MINGKK2/ADCS-satellite-using-stm32F405RGT6/docs/diagrams/diagram-saved.png

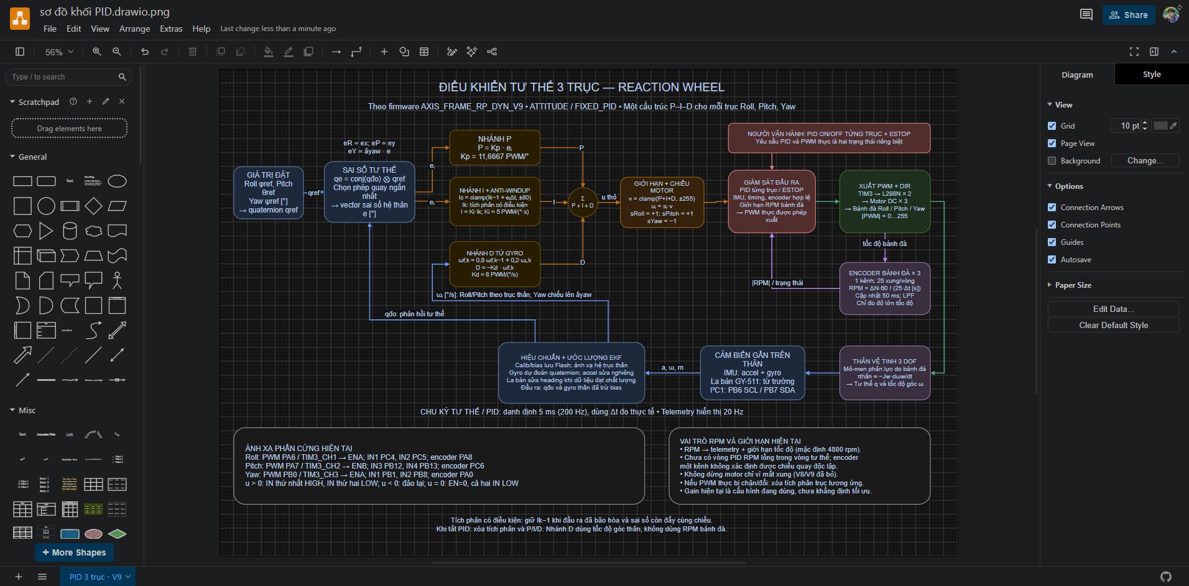
docs/diagrams/diagram-saved.png
