MINGKK2/ADCS-satellite-using-stm32F405RGT6/viewer/report-fixtures/synthetic-yaw-step.csv

elapsed_s | pc_elapsed_s | pc_received_utc | board_uptime_ms | sequence | valid | imu_age_ms | gap_before | invalid_reason | estop | firmware | mag_state | mag_state_age_ms | diagnostic_age_ms | kp | ki | kd | angle_roll_deg | angle_pitch_deg | angle_yaw_deg | target_roll_deg | target_pitch_deg | target_yaw_deg | error_roll_deg | error_pitch_deg | error_yaw_deg | bodyError_roll_deg | bodyError_pitch_deg | bodyError_yaw_deg | gyro_roll_deg_s | gyro_pitch_deg_s | gyro_yaw_deg_s | pwm_roll_count | pwm_pitch_count | pwm_yaw_count | requested_roll_count | requested_pitch_count | requested_yaw_count | pidOutput_roll_count | pidOutput_pitch_count | pidOutput_yaw_count | rpm_roll_rpm | rpm_pitch_rpm | rpm_yaw_rpm | pid_roll_enabled | pid_pitch_enabled | pid_yaw_enabled | active_roll_enabled | active_pitch_enabled | active_yaw_enabled | blocked_roll_mask | blocked_pitch_mask | blocked_yaw_mask | installed_roll_present | installed_pitch_present | installed_yaw_present
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
