MINGKK2/ADCS-satellite-using-stm32F405RGT6/firmware/STM32CubeIDE.ioc

Mcu.UserName=STM32F405RGTx
PA11.Signal=USB_OTG_FS_DM
PA12.Signal=USB_OTG_FS_DP
PA13.Signal=SYS_JTMS-SWDIO
PA14.Signal=SYS_JTCK-SWCLK
PB6.Signal=I2C1_SCL
PB7.Signal=I2C1_SDA
PC14-OSC32_IN.Signal=RCC_OSC32_IN
PC15-OSC32_OUT.Signal=RCC_OSC32_OUT
PH0-OSC_IN.Signal=RCC_OSC_IN
PH1-OSC_OUT.Signal=RCC_OSC_OUT
PA9.Signal=USART1_TX
PA10.Signal=USART1_RX
