MINGKK2/ADCS-satellite-using-stm32F405RGT6/firmware/Core/Inc/telemetry_protocol.h

#ifndef TELEMETRY_PROTOCOL_H
#define TELEMETRY_PROTOCOL_H
#include "telemetry_data.h"
#include <stddef.h>
#include <stdint.h>
void TelemetryProtocol_Init(void);
void TelemetryProtocol_Service(const TelemetryData *data);
uint8_t TelemetryProtocol_Event(const uint8_t *data,size_t length);
#endif
