MINGKK2/ADCS-satellite-using-stm32F405RGT6/firmware/Core/Src/dma.c

/* USART1 DMA2 clock/NVIC. Settings are mirrored in STM32CubeIDE.ioc. */
#include "dma.h"
void MX_DMA_Init(void) {
  __HAL_RCC_DMA2_CLK_ENABLE();
  HAL_NVIC_SetPriority(DMA2_Stream2_IRQn,6,0);
  HAL_NVIC_EnableIRQ(DMA2_Stream2_IRQn);
  HAL_NVIC_SetPriority(DMA2_Stream7_IRQn,6,0);
  HAL_NVIC_EnableIRQ(DMA2_Stream7_IRQn);
}
