MINGKK2/ADCS-satellite-using-stm32F405RGT6/tests/test-adcs-cases.c

static void test_geometry(void){
  float q[4]={1,0,0,0},t[3]={0,0,90},e[3];
  assert(ADCS_AttitudeError(q,t,e));assert(fabsf(e[2]-90)<.001f);
  q[0]=-1;assert(ADCS_AttitudeError(q,t,e));assert(fabsf(e[2]-90)<.001f);
  float h=179*DEG_TO_RAD*.5f;q[0]=cosf(h);q[3]=sinf(h);t[2]=-179;
  assert(ADCS_AttitudeError(q,t,e));assert(fabsf(e[2]-2)<.001f);
  /* At roll=90, a world Z heading change is a body +Y rotation. */
  q[0]=q[1]=sqrtf(.5f);q[2]=q[3]=0;t[0]=90;t[1]=0;t[2]=10;
  assert(ADCS_AttitudeError(q,t,e));assert(fabsf(e[0])<.001f&&fabsf(e[1]-10)<.001f&&fabsf(e[2])<.001f);
  q[0]=NAN;assert(!ADCS_AttitudeError(q,t,e));
  fusion_status=HAL_OK;pid_enabled[2]=1;QuaternionNormalize(q);
  assert(fusion_status==HAL_ERROR && pid_enabled[2] && isfinite(q[0]));
  puts("PASS quaternion shortest path, q/-q, mixed axes, invalid quaternion");
}
static void test_pid(void){
  AxisControl_t c={0};
  for(int i=0;i<10000;i++)assert(AxisControl_Update(&c,0,90,0,28,1.2f,4,80,-1,.005f,1)==-255);
  assert(c.integral==0);assert(c.saturated);
  AxisControl_Update(&c,0,0,0,28,1.2f,4,80,-1,.005f,0);
  assert(c.output_pwm==0 && c.i_term==0);
  int command=AxisControl_Update(&c,0,1,0,28,1.2f,4,80,1,.005f,1);
  assert(command==28 && c.error_deg==1);
  puts("PASS actual PID output clamp, saturation anti-windup, disabled reset");
}
static void test_encoder(void){
  memset(wheel_encoder,0,sizeof(wheel_encoder));TIM_TypeDef timer={0};
  WheelEncoder_t *enc=&wheel_encoder[2];motor_command[2]=100;
  WheelEncoder_UpdateOne(enc,&timer,1);assert(!enc->fault_flags);
  WheelEncoder_UpdateOne(enc,&timer,1501);assert(!enc->fault_flags);
  timer.CNT=25;WheelEncoder_UpdateOne(enc,&timer,1551);
  assert(!enc->fault_flags && enc->pulse_seen && enc->last_edge_tick_ms==1551);
  assert(fabsf(enc->raw_rpm-1200)<.001f);
  Motor_ApplySupervisedCommand(2,120);assert(motor_command[2]==120);
  enc->fault_flags=2;Motor_ApplySupervisedCommand(2,120);assert(motor_command[2]==0);
  /* Implausible-rate faults and raw overspeed remain separate from missing pulses. */
  enc->fault_flags=0;enc->rpm=100;enc->raw_rpm=4900;enc->speed_valid=1;
  Motor_ApplySupervisedCommand(2,120);assert(motor_command[2]==0&&enc->overspeed_limited);
  enc->raw_rpm=4700;Motor_ApplySupervisedCommand(2,120);assert(motor_command[2]==0);
  enc->raw_rpm=4500;Motor_ApplySupervisedCommand(2,120);assert(motor_command[2]==120);
  timer.CNT+=100000;WheelEncoder_UpdateOne(enc,&timer,1601);
  assert((enc->fault_flags&2)&&!enc->speed_valid);
  memset(enc,0,sizeof(*enc));enc->counter_is_16_bit=1;enc->previous_count=65530;
  enc->count=INT32_MAX-2;timer.CNT=4;WheelEncoder_UpdateOne(enc,&timer,50);
  assert(enc->last_delta_count==10 && enc->count==INT32_MAX);
  assert(fabsf(enc->raw_rpm-480)<.001f);
  puts("PASS actual encoder PPR, timer wrap, fault latch, raw overspeed/hysteresis, noise, total saturation");
}
static void test_encoder_no_pulse_stop_disabled(void){
  memset(wheel_encoder,0,sizeof(wheel_encoder));memset(pid_enabled,1,sizeof(pid_enabled));
  for(unsigned axis=0;axis<3;axis++){
    TIM_TypeDef timer={0};WheelEncoder_t *enc=&wheel_encoder[axis];enc->counter_is_16_bit=axis!=2;
    for(unsigned sample=1;sample<=1200;sample++){
      WheelEncoder_UpdateOne(enc,&timer,sample*50U);
      int command=sample<=600?255:-255;
      assert(enc->speed_valid && !enc->fault_flags && enc->rpm==0 && enc->count==0);
      assert(Motor_ApplySupervisedCommand((MotorAxis_t)axis,command)==command);
      assert(pid_enabled[axis]);
    }
  }
  memset(motor_command,0,sizeof(motor_command));memset(pid_enabled,0,sizeof(pid_enabled));
  puts("PASS actual all3axes:60seconds without pulses at PWM+/-255 does not fault, block PWM or change PID request");
}
static void test_encoder_recovery(void){
  memset(wheel_encoder,0,sizeof(wheel_encoder));memset(pid_enabled,0,sizeof(pid_enabled));
  memset(motor_command,0,sizeof(motor_command));TIM_TypeDef timer={0};
  WheelEncoder_t *enc=&wheel_encoder[0];enc->fault_flags=2;enc->speed_valid=1;enc->pulse_seen=1;
  assert(!WheelEncoder_CanClear(0)); /* Pulse evidence from before fault is insufficient. */
  timer.CNT=24;WheelEncoder_UpdateOne(enc,&timer,100);assert(!WheelEncoder_CanClear(0));
  timer.CNT=25;WheelEncoder_UpdateOne(enc,&timer,150);assert(WheelEncoder_CanClear(0));
  WheelEncoder_UpdateOne(enc,&timer,50000);assert(WheelEncoder_CanClear(0)&&enc->fault_flags==2);
  pid_enabled[0]=1;assert(!WheelEncoder_CanClear(0));pid_enabled[0]=0;
  motor_command[0]=80;assert(!WheelEncoder_CanClear(0));motor_command[0]=0;
  timer.CNT+=100000;WheelEncoder_UpdateOne(enc,&timer,50001);
  assert(!WheelEncoder_CanClear(0)&&enc->recovery_pulses==0);
  WheelEncoder_UpdateOne(enc,&timer,50051);assert(!WheelEncoder_CanClear(0));
  /* Unsigned tick wrap with zero pulses remains valid zero RPM and never trips. */
  memset(enc,0,sizeof(*enc));timer.CNT=0;motor_command[0]=100;
  enc->previous_tick_ms=UINT32_MAX-100;
  WheelEncoder_UpdateOne(enc,&timer,1398);assert(!enc->fault_flags);
  WheelEncoder_UpdateOne(enc,&timer,1399);assert(!enc->fault_flags&&enc->speed_valid);
  assert(Motor_ApplySupervisedCommand(0,100)==100);
  memset(motor_command,0,sizeof(motor_command));
  puts("PASS actual encoder explicit recovery:25 disarmed pulses, no auto-clear, no armed clear, tick wrap");
}
static void test_accel_covariance(void){
  float bias[3]={0},accel[3]={0,0,16384};AttitudeEKF_Init(bias,accel);
  attitude_ekf.covariance[0][3]=attitude_ekf.covariance[3][0]=.0001f;
  float before=attitude_ekf.covariance[3][3];
  for(int i=0;i<5000;i++)AttitudeEKF_AccelerometerUpdate(0,0,16384);
  assert(fabsf(attitude_ekf.covariance[3][3]-before)<1e-9f);
  for(unsigned i=0;i<6;i++)for(unsigned j=0;j<6;j++){
    assert(isfinite(attitude_ekf.covariance[i][j]));
    assert(fabsf(attitude_ekf.covariance[i][j]-attitude_ekf.covariance[j][i])<1e-7f);
  }
  puts("PASS actual accel update: no false bias covariance reduction, finite symmetric covariance");
}
static void test_fusion(void){
  float bias[3]={0},accel[3]={0,0,16384};AttitudeEKF_Init(bias,accel);
  memset(motor_command,0,sizeof(motor_command));memset(wheel_encoder,0,sizeof(wheel_encoder));
  memset(&magnetometer,0,sizeof(magnetometer));magnetometer.reference_valid=1;
  magnetometer.reference_world[0]=.8f;magnetometer.reference_world[2]=.6f;magnetometer.reference_norm=1;
  float truth=0;
  int16_t ax=(int16_t)lroundf(accel_offset_raw[0]),ay=(int16_t)lroundf(accel_offset_raw[1]);
  int16_t az=(int16_t)lroundf(accel_offset_raw[2]-16384/accel_scale[2]);
  for(int n=0;n<24000;n++){
    float rate=(n>=8000 && n<8400)?45:0;truth+=rate*.005f;
    int16_t gz=(int16_t)lroundf(-(rate+.573f)*GYRO_LSB_PER_DPS);
    tick=(uint32_t)(n+1)*5;
    AttitudeEKF_Update(ax,ay,az,0,0,gz,.005f);
    if(n%4==0){float mag[3]={.8f*cosf(truth*DEG_TO_RAD),-.8f*sinf(truth*DEG_TO_RAD),.6f};AttitudeEKF_MagnetometerUpdate(mag);}
  }
  float roll,pitch,yaw;QuaternionToEuler(attitude_ekf.q,&roll,&pitch,&yaw);
  printf("Actual ESKF synthetic 120s: truth=%.2f yaw=%.4f, biasZ=%.4f deg/s; accepted=%lu rejected=%lu\n",truth,yaw,attitude_ekf.gyro_bias_rad_s[2]*RAD_TO_DEG,(unsigned long)attitude_ekf.mag_accepted,(unsigned long)attitude_ekf.mag_rejected);
  assert(fabsf(yaw-truth)<.1f && fabsf(roll)<.1f && fabsf(pitch)<.1f);
  /* Failed incomplete mag capture retains previous coefficients. */
  magnetometer.offset[0]=123;magnetometer.offset[1]=-234;magnetometer.offset[2]=345;
  assert(GY511_MagCalibrate()==HAL_ERROR);
  assert(magnetometer.offset[0]==123 && magnetometer.offset[1]==-234 && magnetometer.offset[2]==345);
  puts("PASS actual gyro propagation+accel+mag retains rotated 90deg pose; failed mag capture preserves calibration");
}
static void test_compass_dropout(void){
  float bias[3]={0},accel[3]={0,0,16384};AttitudeEKF_Init(bias,accel);
  attitude_ekf.q[0]=cosf(22.5f*DEG_TO_RAD);attitude_ekf.q[3]=sinf(22.5f*DEG_TO_RAD);
  AttitudeEKF_RefreshEuler();
  memset(&magnetometer,0,sizeof(magnetometer));magnetometer.reference_valid=1;
  magnetometer.reference_norm=1000;magnetometer.reference_world[0]=.8f;magnetometer.reference_world[2]=.6f;
  for(unsigned i=0;i<3;i++)magnetometer.scale[i]=1;
  fusion_status=HAL_OK;mag_status=HAL_OK;pid_enabled[2]=1;
  float initial_q[4];memcpy(initial_q,attitude_ekf.q,sizeof(initial_q));
  for(unsigned i=0;i<20;i++){tick+=20;Magnetometer_ProcessSample(HAL_ERROR,0,0,0);}
  assert(mag_status==HAL_ERROR && fusion_status==HAL_OK && pid_enabled[2]);
  assert(!memcmp(initial_q,attitude_ekf.q,sizeof(initial_q)));
  int16_t ax=(int16_t)lroundf(accel_offset_raw[0]),ay=(int16_t)lroundf(accel_offset_raw[1]);
  int16_t az=(int16_t)lroundf(accel_offset_raw[2]-16384/accel_scale[2]);
  AxisControl_t control={0};control.setpoint_deg=45;
  for(unsigned i=0;i<1200;i++){
    tick+=5;AttitudeEKF_Update(ax,ay,az,0,0,0,.005f);
    if(i%4==0)Magnetometer_ProcessSample(HAL_ERROR,0,0,0);
    float target[3]={0,0,45},error[3];assert(ADCS_AttitudeError(attitude_ekf.q,target,error));
    (void)AxisControl_Update(&control,attitude_ekf.yaw_deg,error[2],0,28,1.2f,4,80,-1,.005f,pid_enabled[2]);
  }
  assert(pid_enabled[2] && fusion_status==HAL_OK && fabsf(attitude_ekf.yaw_deg-45)<.1f);
  Magnetometer_ProcessSample(HAL_OK,10000,0,0);
  assert(mag_reject_reason==1 && pid_enabled[2] && fusion_status==HAL_OK);
  Magnetometer_ProcessSample(HAL_OK,-566,-566,600);
  assert(mag_reject_reason==3 && fabsf(mag_innovation_deg)>100 && pid_enabled[2]);
  Magnetometer_ProcessSample(HAL_OK,566,566,600);
  assert(mag_status==HAL_OK && mag_reject_reason==0 && pid_enabled[2] && fusion_status==HAL_OK);
  assert(fabsf(attitude_ekf.yaw_deg-45)<.1f && control.setpoint_deg==45);
  puts("PASS actual 6s compass I2C dropout, rejected norm/heading and recovery: PID stays enabled, IMU runs, angle/target retained");
}
static void test_operator_authority(void){
  control_targets_initialized=1;pid_enabled[0]=1;pid_enabled[1]=0;pid_enabled[2]=1;
  roll_control.setpoint_deg=10;pitch_control.setpoint_deg=20;yaw_control.setpoint_deg=90;
  attitude_ekf.yaw_deg=45;attitude_ekf.roll_deg=0;attitude_ekf.pitch_deg=0;
  AttitudeControl_Reset();
  assert(pid_enabled[0]&&!pid_enabled[1]&&pid_enabled[2]);
  assert(roll_control.setpoint_deg==10&&pitch_control.setpoint_deg==20&&yaw_control.setpoint_deg==90);
  float bias[3]={0},accel[3]={0,0,16384};AttitudeEKF_Init(bias,accel);
  assert(fabsf(attitude_ekf.yaw_deg-45)<.001f);
  AttitudeControl_Reset();assert(pid_enabled[2]&&yaw_control.setpoint_deg==90);
  float measured_before[4];memcpy(measured_before,attitude_ekf.q,sizeof(measured_before));
  AttitudeControl_HoldCurrentYaw();
  assert(fabsf(yaw_control.setpoint_deg-45)<.001f && pid_enabled[2]);
  assert(!memcmp(measured_before,attitude_ekf.q,sizeof(measured_before)));
  puts("PASS operator PID latch/targets survive controller and EKF recovery; retained yaw is measured 45deg, not target 90deg");
  control_timing_paused=0;
  assert(ControlTiming_Accept(5,0)&&!control_timing_paused);
  assert(ControlTiming_Accept(25,100)&&control_timing_paused);
  assert(ControlTiming_Accept(5,199)&&control_timing_paused);
  assert(ControlTiming_Accept(5,200)&&!control_timing_paused);
  assert(!ControlTiming_Accept(101,250)&&control_timing_paused&&pid_enabled[2]);
  control_timing_paused=0;
  assert(ControlTiming_Accept(25,0xFFFFFFF0U)&&control_timing_paused);
  assert(ControlTiming_Accept(5,83)&&control_timing_paused);
  assert(ControlTiming_Accept(5,84)&&!control_timing_paused&&pid_enabled[2]);
  puts("PASS timing pause/recovery and tick wrap: 25ms does not reinitialize EKF, >100ms requests recovery but never clears operator PID");
}
static void test_autonomous_hold(void){
  control_targets_initialized=1;control_timing_paused=0;
  pid_enabled[0]=pid_enabled[1]=0;pid_enabled[2]=1;
  roll_control.setpoint_deg=pitch_control.setpoint_deg=0;yaw_control.setpoint_deg=90;
  attitude_ekf.q[0]=cosf(22.5f*DEG_TO_RAD);attitude_ekf.q[1]=attitude_ekf.q[2]=0;
  attitude_ekf.q[3]=sinf(22.5f*DEG_TO_RAD);AttitudeEKF_RefreshEuler();
  AttitudeControl_Reset();
  for(unsigned i=0;i<120000;i++){
    tick+=5;assert(ControlTiming_Accept(5,tick));
    if(i==60000)AttitudeControl_Reset();
    float target[3]={0,0,yaw_control.setpoint_deg},error[3];
    assert(ADCS_AttitudeError(attitude_ekf.q,target,error));
    int32_t pwm=AxisControl_Update(&yaw_control,attitude_ekf.yaw_deg,error[2],0,28,2.4f,8,80,-1,.005f,pid_enabled[2]);
    assert(pid_enabled[2]&&yaw_control.setpoint_deg==90);
    assert(fabsf(attitude_ekf.yaw_deg-45)<.001f&&pwm>=-255&&pwm<=255&&pwm!=0);
  }
  puts("PASS autonomous hold: 600 simulated seconds without commands; target/PID survive controller recovery; measured 45deg remains separate from target 90deg");
}
static void test_measured_body_frame(void){
  float old[3]={.01f,.02f,.03f},body[3],restored[3];
  ADCS_LegacyToBody(old,body);ADCS_BodyToLegacy(body,restored);
  assert(body[0]==old[1]&&body[1]==-old[0]&&body[2]==old[2]);
  assert(!memcmp(old,restored,sizeof(old)));
  float ex[3]={1,0,0},ey[3]={0,1,0},ez[3]={0,0,1};
  ADCS_LegacyToBody(ex,ex);ADCS_LegacyToBody(ey,ey);ADCS_LegacyToBody(ez,ez);
  float cross[3]={ex[1]*ey[2]-ex[2]*ey[1],ex[2]*ey[0]-ex[0]*ey[2],ex[0]*ey[1]-ex[1]*ey[0]};
  for(unsigned i=0;i<3;i++)assert(cross[i]==ez[i]);
  float gy[3];SensorToBodyGyroRad(0,GYRO_LSB_PER_DPS,0,gy);
  assert(fabsf(gy[0]-DEG_TO_RAD)<1e-7f&&gy[1]==0&&gy[2]==0);
  SensorToBodyGyroRad(GYRO_LSB_PER_DPS,0,0,gy);
  assert(gy[0]==0&&fabsf(gy[1]-DEG_TO_RAD)<1e-7f&&gy[2]==0);
  SensorToBodyGyroRad(0,0,GYRO_LSB_PER_DPS,gy);
  assert(gy[0]==0&&gy[1]==0&&fabsf(gy[2]+DEG_TO_RAD)<1e-7f);
  /* Reproduce the held physical Roll pose: legacy pitch +30 degrees. */
  float accel[3],zero[3]={0};control_targets_initialized=0;
  SensorToBodyAccel(accel_offset_raw[0]+.5f*ACCEL_LSB_PER_G/accel_scale[0],
      accel_offset_raw[1],accel_offset_raw[2]-.8660254f*ACCEL_LSB_PER_G/accel_scale[2],accel);
  AttitudeEKF_Init(zero,accel);
  assert(fabsf(attitude_ekf.roll_deg-30)<.001f&&fabsf(attitude_ekf.pitch_deg)<.001f);
  float target[3]={0},error[3];assert(ADCS_AttitudeError(attitude_ekf.q,target,error));
  assert(fabsf(error[0]+30)<.001f&&fabsf(error[1])<.001f);
  /* Legacy roll +30 is new pitch -30 when preserving the existing +Yaw. */
  SensorToBodyAccel(accel_offset_raw[0],accel_offset_raw[1]+.5f*ACCEL_LSB_PER_G/accel_scale[1],
      accel_offset_raw[2]-.8660254f*ACCEL_LSB_PER_G/accel_scale[2],accel);
  AttitudeEKF_Init(zero,accel);
  assert(fabsf(attitude_ekf.roll_deg)<.001f&&fabsf(attitude_ekf.pitch_deg+30)<.001f);
  assert(ADCS_AttitudeError(attitude_ekf.q,target,error));
  assert(fabsf(error[1]-30)<.001f&&fabsf(error[0])<.001f);
  memset(&magnetometer,0,sizeof(magnetometer));for(unsigned i=0;i<3;i++)magnetometer.scale[i]=1;
  GY511_MagToBody(100,200,300,body);assert(body[0]==200&&body[1]==-100&&body[2]==300);
  float legacy_axis[3]={YAW_LEGACY_AXIS_X,YAW_LEGACY_AXIS_Y,YAW_LEGACY_AXIS_Z};
  ADCS_LegacyToBody(legacy_axis,body);
  assert(body[0]==YAW_AXIS_X&&body[1]==YAW_AXIS_Y&&body[2]==YAW_AXIS_Z);
  puts("PASS measured Roll/Pitch mounting, right-handed rotation, gyro/mag consistency, yaw-axis preservation and PID error on the correct body axis");
}
static int16_t test_sensor_word(float value){return (int16_t)lroundf(fmaxf(-32768,fminf(32767,value)));}
static void test_body_sample(float axg,float ayg,float azg,float yaw_rate){
  /* Inverse of the verified current body basis: body=(sensorY,sensorX,-sensorZ). */
  int16_t ax=test_sensor_word(accel_offset_raw[0]+ayg*ACCEL_LSB_PER_G/accel_scale[0]);
  int16_t ay=test_sensor_word(accel_offset_raw[1]+axg*ACCEL_LSB_PER_G/accel_scale[1]);
  int16_t az=test_sensor_word(accel_offset_raw[2]-azg*ACCEL_LSB_PER_G/accel_scale[2]);
  tick+=5;AttitudeEKF_Update(ax,ay,az,0,0,test_sensor_word(-yaw_rate*GYRO_LSB_PER_DPS),.005f);
}
static void test_dynamic_attitude(void){
  float bias[3]={0},accel[3]={0,0,ACCEL_LSB_PER_G};control_targets_initialized=0;tick=0;AttitudeEKF_Init(bias,accel);
  for(unsigned n=0;n<240;n++)test_body_sample(0,0,1,n<40?400:(n<200?-100:0));
  float fast_return=attitude_ekf.yaw_deg;
  control_targets_initialized=0;tick=0;AttitudeEKF_Init(bias,accel);float max_tilt=0;
  for(unsigned n=0;n<1600;n++){
    float t=n*.005f;int moving=n>=200&&n<1000;
    float x=moving?.06f*sinf(6.283185307f*2.5f*t):0;
    float y=moving?.06f*cosf(6.283185307f*3.5f*t):0;
    test_body_sample(x,y,sqrtf(1-x*x-y*y),n>=200&&n<600?30:(n>=600&&n<1000?-30:0));
    if(moving)max_tilt=fmaxf(max_tilt,fmaxf(fabsf(attitude_ekf.roll_deg),fabsf(attitude_ekf.pitch_deg)));
  }
  control_targets_initialized=0;tick=0;AttitudeEKF_Init(bias,accel);
  attitude_ekf.q[0]=cosf(17.5f*DEG_TO_RAD);attitude_ekf.q[1]=sinf(17.5f*DEG_TO_RAD);
  for(unsigned n=0;n<600;n++)test_body_sample(0,0,1,0);
  printf("DYNAMIC actual source: asymmetric400/-100dps return error=%.3fdeg, yaw-only vibration maxfalse tilt=%.3fdeg, stationary35deg recovery=%.3fdeg\n",fast_return,max_tilt,attitude_ekf.roll_deg);
  assert(fabsf(fast_return)<1.0f && max_tilt<1.1f && fabsf(attitude_ekf.roll_deg)<1.0f);
}
static void test_fast_real_three_axis_motion(void){
  float max_error=0;
  for(unsigned axis=0;axis<3;axis++){
    float bias[3]={0},gravity[3]={0,0,ACCEL_LSB_PER_G};control_targets_initialized=0;tick=0;AttitudeEKF_Init(bias,gravity);float angle=0;
    for(unsigned n=0;n<220;n++){
      float rate=n<40?350:(n<180?-100:0);angle+=rate*.005f;
      float sn=sinf(angle*DEG_TO_RAD),cs=cosf(angle*DEG_TO_RAD);
      float a[3]={axis==1?-sn:0,axis==0?sn:0,axis==2?1:cs};
      int16_t ax=test_sensor_word(accel_offset_raw[0]+a[1]*ACCEL_LSB_PER_G/accel_scale[0]);
      int16_t ay=test_sensor_word(accel_offset_raw[1]+a[0]*ACCEL_LSB_PER_G/accel_scale[1]);
      int16_t az=test_sensor_word(accel_offset_raw[2]-a[2]*ACCEL_LSB_PER_G/accel_scale[2]);
      tick+=5;AttitudeEKF_Update(ax,ay,az,axis==1?test_sensor_word(rate*GYRO_LSB_PER_DPS):0,axis==0?test_sensor_word(rate*GYRO_LSB_PER_DPS):0,axis==2?test_sensor_word(-rate*GYRO_LSB_PER_DPS):0,.005f);
      float dot=attitude_ekf.q[0]*cosf(.5f*angle*DEG_TO_RAD)+attitude_ekf.q[axis+1]*sinf(.5f*angle*DEG_TO_RAD);
      float error=2*acosf(fminf(1,fabsf(dot)))*RAD_TO_DEG;max_error=fmaxf(max_error,error);
    }
    assert(attitude_ekf.gyro_clipped_samples==0);
  }
  assert(max_error<.3f);
  test_body_sample(0,0,1,1200);assert(attitude_ekf.gyro_clipped_samples==1);
  printf("PASS actual fast350/-100dps70deg moves on all3axes retain real tilt: maxquaternion error%.3fdeg; clipping counter works\n",max_error);
}
int main(void){test_geometry();test_pid();test_encoder();test_encoder_no_pulse_stop_disabled();test_encoder_recovery();test_accel_covariance();test_fusion();test_compass_dropout();test_operator_authority();test_autonomous_hold();test_measured_body_frame();test_dynamic_attitude();test_fast_real_three_axis_motion();}
