MINGKK2/ADCS-satellite-using-stm32F405RGT6/(commit log)

2026-11-01 Record verified DFU deployment and preserved calibration
2026-11-01 Keep PID authority with operator and add staged S3-C3 UART firmware updater
2026-11-01 Stabilize bidirectional ESP-NOW updater and prepare ROM-UART application startup
    [esp32c3_uart_bridge.ino, esp32s3_ground_station.ino, main.c]
2026-11-01 Publish ADCS V4 with corrected Pitch polarity and reduced Kp
    [axis_frame.h, calibration_store.h, esp32c3_uart_bridge.ino, esp32s3_ground_station.ino, line_assembler.h, main.c, telemetry_data.h]
2026-11-02 Publish ADCS V9 attitude dynamics, encoder policy and current viewer
    [synthetic-yaw-step.csv]
